gustavojm/SM13_PCB/Capturas/frente_sm13.jpg

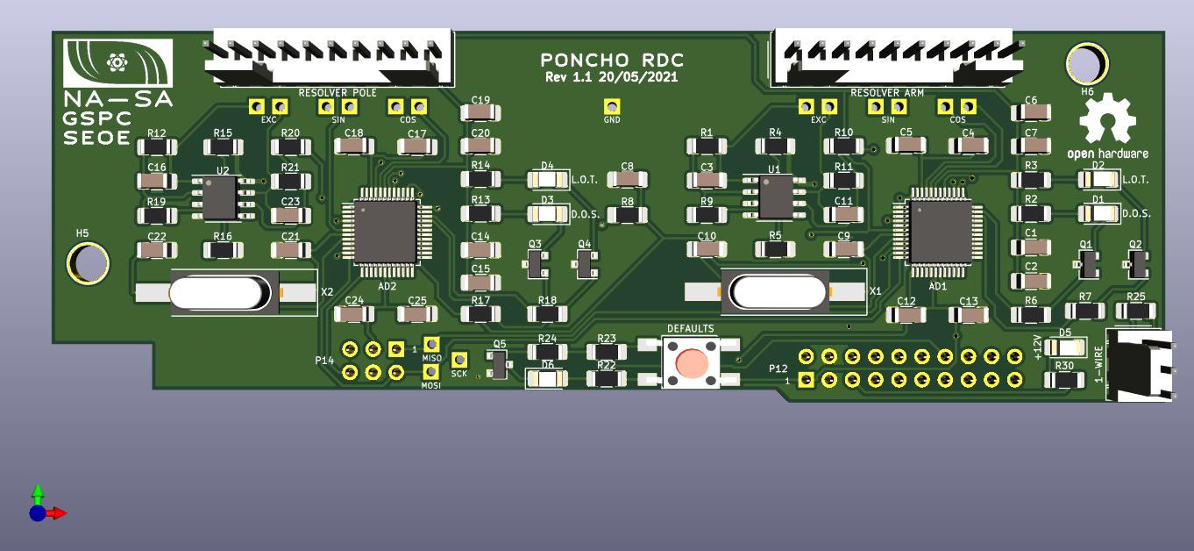
Capturas/frente_sm13.jpg
