gustavojm/SM13_PCB/Capturas/atras_sm13.jpg

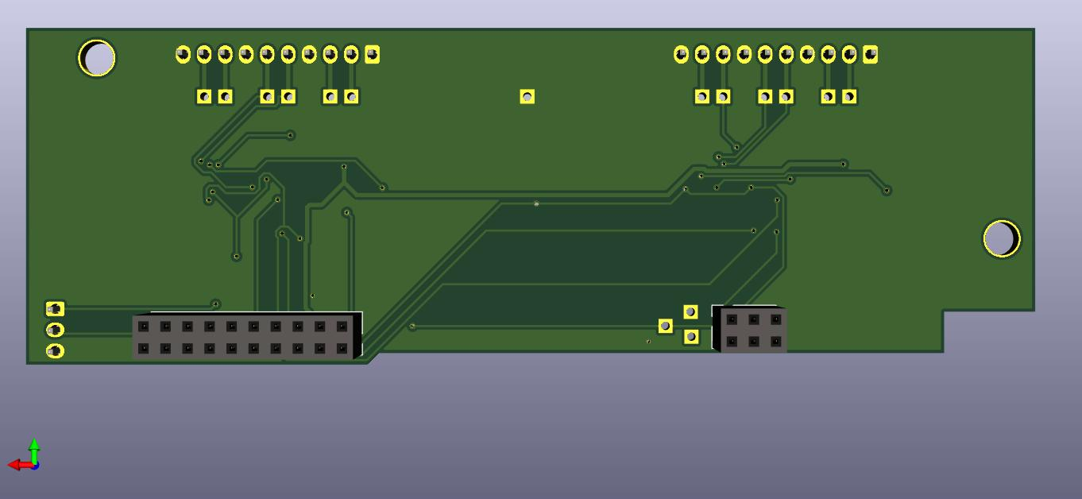
Capturas/atras_sm13.jpg
