gustavojm/SM13_PCB/README.md

# New Fixture Controller #
* Autor: DEEE
* GSPC

Poncho para la CIAA NXP con los RDC

Foto Hasta la vista baby
