gustavojm/SM13_PCB/Capturas/juntas.jpg

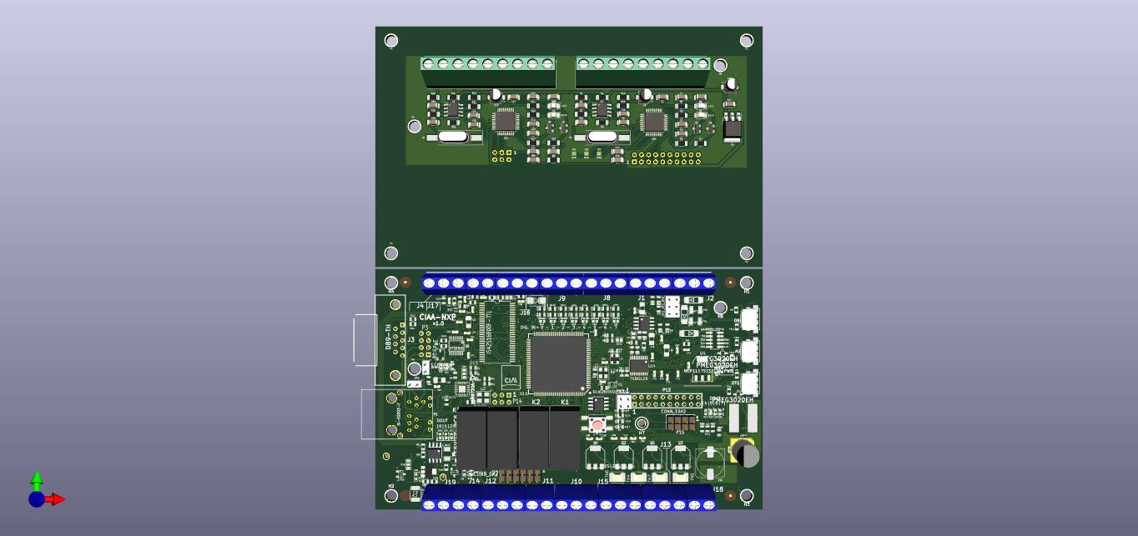
Capturas/juntas.jpg
