gustavojm/SM13_PCB/(list of files, drawings)

Other design files:
principal_sm13.dsn
