gustavojm/SM13_PCB/principal_sm13.kicad_pcb

## KiCad design principal_sm13.kicad_pcb (2021-05-21)

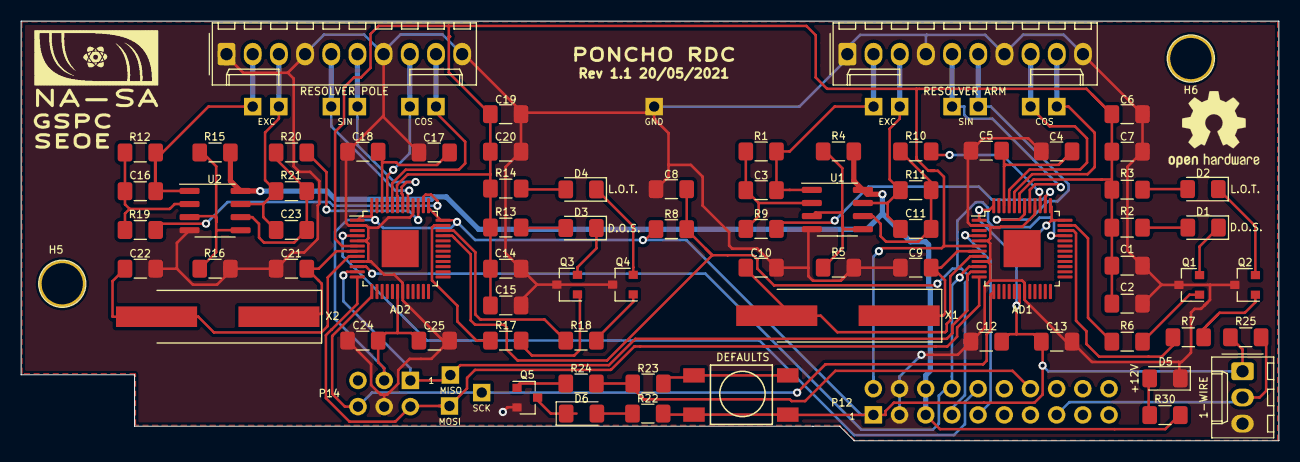
[picture p16: board principal_sm13.kicad_pcb from above]

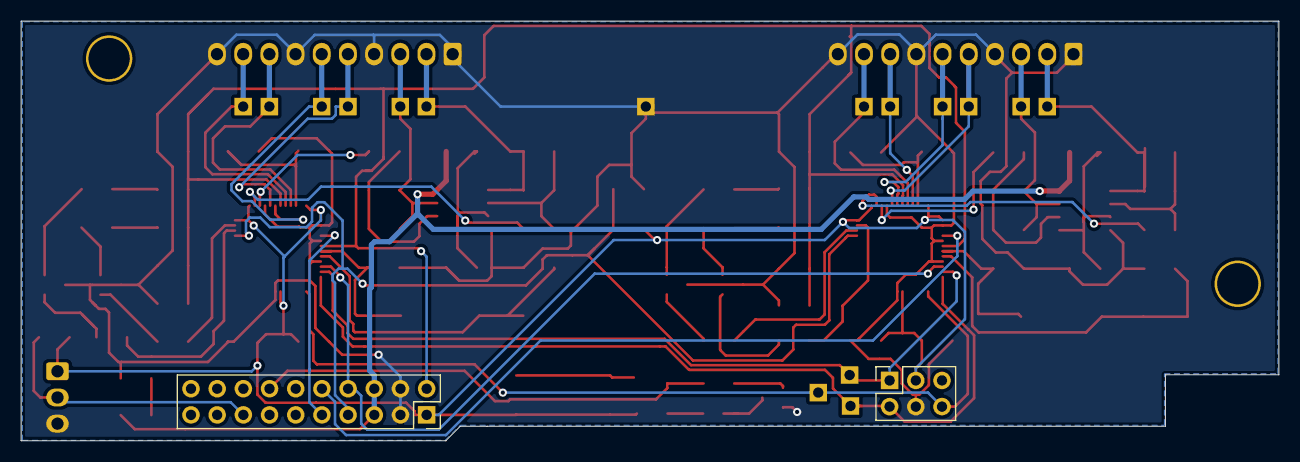
[picture p17: board principal_sm13.kicad_pcb from below]

Board: 2 copper layers, 122.0 x 40.7 mm, 93 parts (2 on the bottom side), 62 nets.

Parts:
AD1, AD2: AD2S1210; LQFP-48-1EP_7x7mm_P0.5mm_EP3.6x3.6mm
C1, C7, C13, C14, C20, C25: 4,7µ; C_1206_3216Metric_Pad1.42x1.75mm_HandSolder
C2, C4, C6, C12, C15, C17, C19, C24: 10n; C_1206_3216Metric_Pad1.42x1.75mm_HandSolder
C3, C11, C16, C23: 120p; C_1206_3216Metric_Pad1.42x1.75mm_HandSolder
C5, C18: 10µ; C_1206_3216Metric_Pad1.42x1.75mm_HandSolder
C8: 100n; C_1206_3216Metric_Pad1.42x1.75mm_HandSolder
C9, C10, C21, C22: 20p; C_1206_3216Metric_Pad1.42x1.75mm_HandSolder
D1, D2, D3, D4, D5, D6: LED; LED_1206_3216Metric_Pad1.42x1.75mm_HandSolder
H5, H6: 4mm; 1pin
J1: RESOLVER ARM; Molex_KK-254_AE-6410-10A_1x10_P2.54mm_Vertical
J2: RESOLVER POLE; Molex_KK-254_AE-6410-10A_1x10_P2.54mm_Vertical
J3: 1-WIRE; Molex_KK-254_AE-6410-03A_1x03_P2.54mm_Vertical
LOGO: logo_nasa
P12: CONN_10X2; PinSocket_2x10_P2.54mm_Vertical
P14: SPI; PinSocket_2x03_P2.54mm_Vertical
Q1, Q2, Q3, Q4: BC807; SOT-23
Q5: BC817; SOT-23
R1, R11, R12, R21: 12K; R_1206_3216Metric_Pad1.42x1.75mm_HandSolder
R2, R3, R13, R14, R22: 120; R_1206_3216Metric_Pad1.42x1.75mm_HandSolder
R4, R15: 22K; R_1206_3216Metric_Pad1.42x1.75mm_HandSolder
R5, R8, R9, R10, R16, R19, R20: 10K; R_1206_3216Metric_Pad1.42x1.75mm_HandSolder
R6, R7, R17, R18, R23, R24: 1K; R_1206_3216Metric_Pad1.42x1.75mm_HandSolder
R25: 4,7K; R_1206_3216Metric_Pad1.42x1.75mm_HandSolder
R30: 560; R_1206_3216Metric_Pad1.42x1.75mm_HandSolder
SW1: DEFAULTS; PUSH_SWITCH
TP1: TP_SCK; TestPoint_reducido
TP2: TP_MOSI; TestPoint_reducido
TP3: TP_MISO; TestPoint_reducido
TP4: TPCOSARM; TestPoint_reducido
TP5: TPCOSLOARM; TestPoint_reducido
TP6: TPSINLOARM; TestPoint_reducido
TP7: TPSINARM; TestPoint_reducido
TP8: TPEXCARM; TestPoint_reducido
TP9: TPEXCLOARM; TestPoint_reducido
TP10: TPCOSPOLE; TestPoint_reducido
TP11: TPCOSLOPOLE; TestPoint_reducido
TP12: TPSINLOPOLE; TestPoint_reducido
TP13: TPSINPOLE; TestPoint_reducido
TP14: TPEXCPOLE; TestPoint_reducido
TP15: TPEXCLOPOLE; TestPoint_reducido
TP16: TPGND; TestPoint_reducido
U1, U2: AD8397ARZ; SOIC-8_3.9x4.9mm_P1.27mm
X1, X2: 8.192MHz; Crystal_SMD_HC49-SD_HandSoldering

Connections:
+3V3: AD1.1, AD1.18, AD1.36, AD1.37, AD1.48, AD2.1, AD2.18, AD2.36, AD2.37, AD2.48, C12.1, C13.1, C24.1, C25.1, J3.1, P12.1, P14.3, R8.1, R22.1, R25.1, SW1.1, SW1.2
+5V: AD1.6, AD1.43, AD2.6, AD2.43, C1.1, C2.1, C6.2, C7.1, C14.1, C15.1, C19.2, C20.1, P12.2, R2.1, R3.1, R13.1, R14.1
+12V: P12.5, P12.6, R4.2, R15.2, R30.1, U1.8, U2.8
/GPIO/GPIO0: AD1.33, AD2.33, C8.1, P12.7, R8.2
/GPIO/GPIO1: AD1.10, AD2.10, P12.8
/GPIO/GPIO2: AD1.4, P12.9
/GPIO/GPIO3: AD2.4, P12.10
/GPIO/GPIO7: P12.14, R23.2, R24.2
/GPIO/GPIO8: J3.2, P12.15, R25.2
/GPIO/SPI_SCK: AD1.13, AD2.13, P14.6, TP1.1
/RDC ARM/COS: AD1.45, J1.8, TP4.1
/RDC ARM/COSLO: AD1.44, J1.9, TP5.1
/RDC ARM/EXC: AD1.38, R9.1
/RDC ARM/MISO: AD1.11, AD2.11, P14.1, TP3.1
/RDC ARM/MOSI: AD1.12, AD2.12, P14.2, TP2.1
/RDC ARM/SIN: AD1.41, J1.5, TP7.1
/RDC ARM/SINLO: AD1.42, J1.6, TP6.1
/RDC ARM/~EXC: AD1.39, R10.1
/RDC POLE/COS: AD2.45, J2.8, TP10.1
/RDC POLE/COSLO: AD2.44, J2.9, TP11.1
/RDC POLE/EXC: AD2.38, R19.1
/RDC POLE/SIN: AD2.41, J2.5, TP13.1
/RDC POLE/SINLO: AD2.42, J2.6, TP12.1
/RDC POLE/~EXC: AD2.39, R20.1
GND: AD1.2, AD1.5, AD1.9, AD1.19, AD1.40, AD2.2, AD2.5, AD2.9, AD2.19, AD2.40, C1.2, C2.2, C4.2, C5.2, C6.1, C7.2, C8.2, C9.2, C10.2, C12.2, C13.2, C14.2, C15.2, C17.2, C18.2, C19.1, C20.2, C21.2, C22.2, C24.2, C25.2, D5.1, J1.1, J1.4, J1.7, J1.10, J2.1, J2.4, J2.7, J2.10, J3.3, P12.3, P12.4, P14.4, Q1.3, Q2.3, Q3.3, Q4.3, Q5.2, R5.1, R16.1, TP16.1, U1.4, U2.4
unnamed: AD1.7, C9.1, X1.1
unnamed: AD1.8, C10.1, X1.2
unnamed: AD1.34, R7.2
unnamed: AD1.35, R6.2
unnamed: AD1.46, C4.1, C5.1
unnamed: AD2.7, C21.1, X2.1
unnamed: AD2.8, C22.1, X2.2
unnamed: AD2.34, R18.2
unnamed: AD2.35, R17.2
unnamed: AD2.46, C17.1, C18.1
unnamed: C3.1, J1.2, R1.1, TP8.1, U1.1
unnamed: C3.2, R1.2, R9.2, U1.2
unnamed: C11.1, J1.3, R11.1, TP9.1, U1.7
unnamed: C11.2, R10.2, R11.2, U1.6
unnamed: C16.1, J2.2, R12.1, TP14.1, U2.1
unnamed: C16.2, R12.2, R19.2, U2.2
unnamed: C23.1, J2.3, R21.1, TP15.1, U2.7
unnamed: C23.2, R20.2, R21.2, U2.6
unnamed: D1.1, Q1.2
unnamed: D1.2, R2.2
unnamed: D2.1, Q2.2
unnamed: D2.2, R3.2
unnamed: D3.1, Q3.2
unnamed: D3.2, R13.2
unnamed: D4.1, Q4.2
unnamed: D4.2, R14.2
unnamed: D5.2, R30.2
unnamed: D6.1, Q5.3
unnamed: D6.2, R22.2
unnamed: Q1.1, R6.1
unnamed: Q2.1, R7.1
unnamed: Q3.1, R17.1
unnamed: Q4.1, R18.1
unnamed: Q5.1, R24.1
unnamed: R4.1, R5.2, U1.3, U1.5
unnamed: R15.1, R16.2, U2.3, U2.5
unnamed: R23.1, SW1.3, SW1.4
