gustavojm/SM13_PCB/(commit log)

2020-06-24 Commit inicial
    [Conector GPIO.sch, Fuente_12v.sch, RDC_ARM.sch, gpio-2020-06-22-17-23-46.sch, principal_sm13.sch, principal_sm13_con_push_pull.sch, push_pull.sch]
2020-06-25 resolución fijada en 16 bits y modo configuración fijado
    [Conector GPIO.sch, RDC_ARM.sch, principal_sm13.sch]
2020-07-03 agregado el segundo RDC, leds conectados a +5v, asignados footprints
    [Conector GPIO.sch, Fuente_12v.sch, RDC_POLE.sch, principal_sm13.kicad_pcb, principal_sm13.sch]
2020-07-04 cambios en el placement
    [Conector GPIO.sch, Fuente_12v.sch, RDC_ARM.sch, RDC_POLE.sch, principal_sm13.kicad_pcb]
2020-07-04 componentes montados sobre placa CIAA NXP para hacer el sandwich
    [principal_sm13.kicad_pcb]
2020-07-06 reubicados componentes, cambiado regulador a SMD
    [Fuente_12v.sch, principal_sm13.kicad_pcb]
2020-07-06 routeado completo, quedan 32 vias
    [Conector GPIO.sch, RDC_ARM.sch, RDC_POLE.sch, principal_sm13.dsn, principal_sm13.kicad_pcb]
2020-07-07 reducida la placa para que queden libres los conectores de la CIAA, ruteado completo, quedan 38 vias
    [principal_sm13.dsn, principal_sm13.kicad_pcb]
2020-07-07 agregadas zonas de relleno conecadas a GND
    [principal_sm13.kicad_pcb]
2020-07-07 agregados test points parara comunicacion SPI, ruteado, 28 vias
    [principal_sm13.dsn, principal_sm13.kicad_pcb, principal_sm13.sch]
2020-07-07 el freerouting no conecta bien si hay zonas llenas, 30 vias
    [principal_sm13.dsn, principal_sm13.kicad_pcb]
2020-07-07 preliminar, 30 vias
    [principal_sm13.dsn, principal_sm13.kicad_pcb]
2020-07-08 cambiados conectores, agregado conversor 3,3->TTL drivers
    [Conector GPIO.sch, DRIVER_MOTOR.sch, Fuente_12v.sch, RDC_ARM.sch, RDC_POLE.sch, principal_sm13.dsn, principal_sm13.sch]
2020-07-08 ajustada el area contra los reles
    [principal_sm13.kicad_pcb]
2020-07-08 cambiado a conectores MOLEX KK, agregados test points para señales analogicas
    [DRIVER_MOTOR.sch, Fuente_12v.sch, RDC_ARM.sch, RDC_POLE.sch, principal_sm13.dsn, principal_sm13.kicad_pcb]
2020-07-14 outline reducido, para revision por peers
    [Fuente_12v.sch, RDC_ARM.sch, RDC_POLE.sch, principal_sm13.sch]
2020-07-15 eliminado regulador 12v, alimentar CIAA con 12v directamente
    [Conector GPIO.sch, DRIVER_MOTOR.sch, RDC_ARM.sch, RDC_POLE.sch, principal_sm13.dsn, principal_sm13.kicad_pcb, principal_sm13.sch]
2020-07-16 cambiados capacitores electroliticos por tantalio (unpolarized). Agrandado footprint test pads, generado BOM, 35 vias
    [Conector GPIO.sch, DRIVER_MOTOR.sch, RDC_ARM.sch, RDC_POLE.sch, principal_sm13.dsn, principal_sm13.kicad_pcb, principal_sm13.sch]
2020-07-17 agrandados pads de test points
    [Conector GPIO.sch, RDC_ARM.sch, RDC_POLE.sch, principal_sm13.dsn, principal_sm13.kicad_pcb, principal_sm13.sch]
2020-07-17 agregado logo OSHW y nomy nombre poncho
    [principal_sm13.kicad_pcb]
2020-07-17 movido texto poncho y alejada pista alrededor de H6
    [principal_sm13.kicad_pcb]
2020-07-28 modificado cambiador de nivel de salida, agregados TP para los gpio STEP y DIRECTION de los motore PAP
    [DRIVER_MOTOR.sch, principal_sm13.dsn, principal_sm13.kicad_pcb]
2020-07-28 regenerado BOM
2020-07-28 alejadas algunas pistas, thermal pads clearance = 0
    [principal_sm13.kicad_pcb]
2020-07-31 agrandado tipo letra leyendas, generados archivos Gerber de fabricación
    [principal_sm13-B_Cu.gbl, principal_sm13-B_Mask.gbs, principal_sm13-B_SilkS.gbo, principal_sm13-Edge_Cuts.gm1, principal_sm13-F_Cu.gtl, principal_sm13-F_Mask.gts, principal_sm13-drl_map.gbr, principal_sm13.drl]
2020-08-20 eliminado gpio para motores ya que la CIAA no cuenta con suficientes GPIOs disponibles. Se usara DOUTS
    [BOM.csv, Conector GPIO.sch, DRIVER_MOTOR.sch, RDC_ARM.sch, RDC_POLE.sch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]
2021-05-21 Se arregló conexion erronea en los amplificadores operacionales
    se agregó conexión 1-wire en GPIO8
    se agregó botón y led que comparten GPIO7, la idea es leer el estado del
    botón y al liberarlo cambiar el GPIO a output y encender el led indicando
    alguna acción
    [Conector GPIO.sch, RDC_ARM.sch, RDC_POLE.sch, principal_sm13.kicad_pcb, principal_sm13.sch]
